ChaseZhang-ai/chipDesign/docs/images/die_shot_ame.png

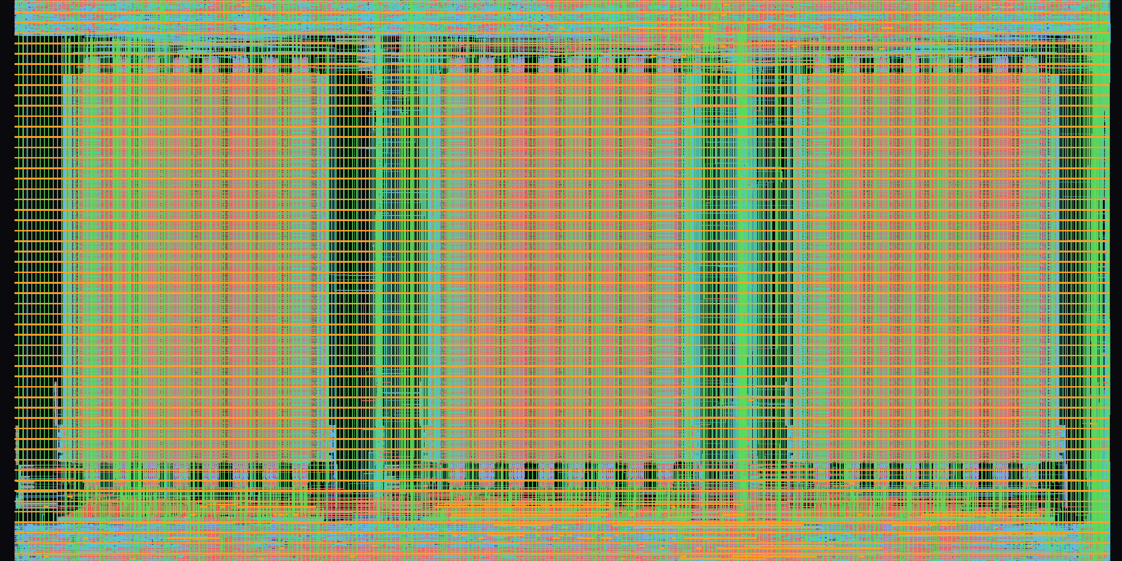
docs/images/die_shot_ame.png
