ChaseZhang-ai/chipDesign/docs/images/die_shot_full.png

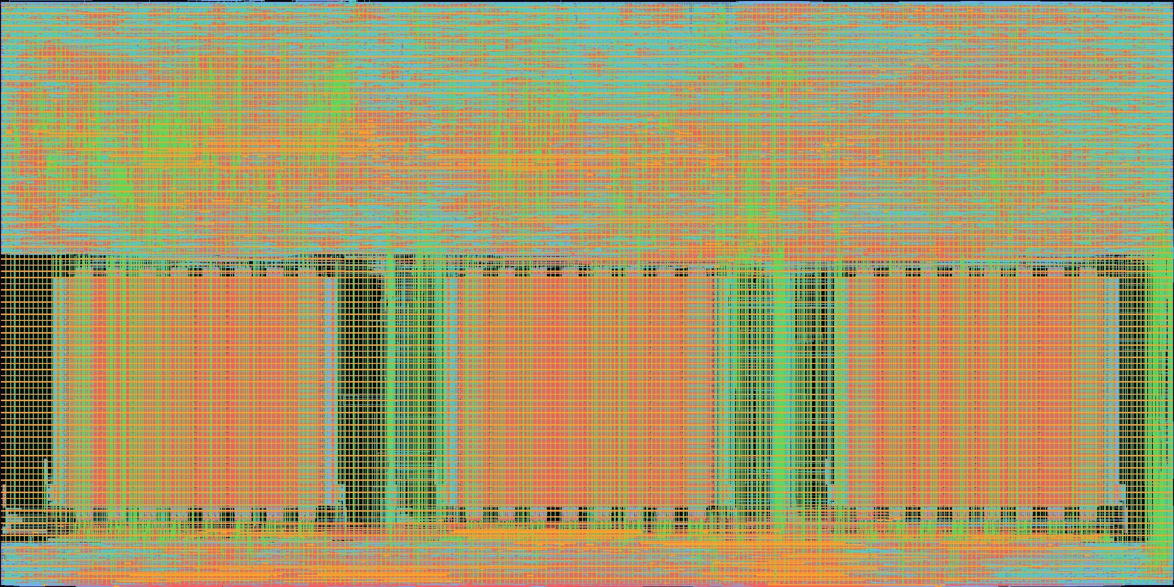
docs/images/die_shot_full.png
