ChaseZhang-ai/chipDesign/reports/P4B_gds_full.png

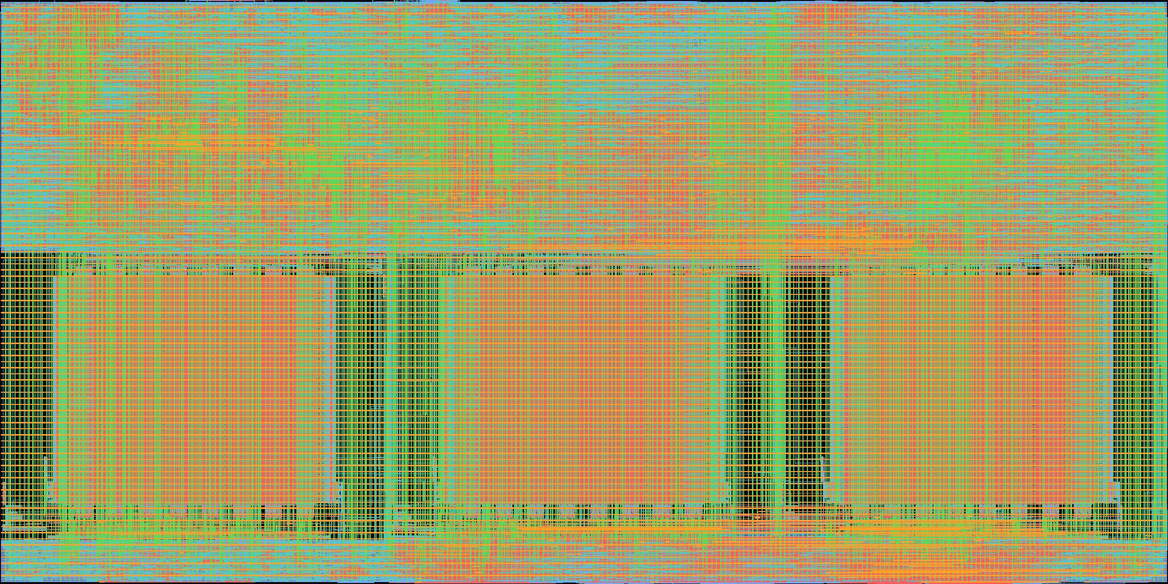
reports/P4B_gds_full.png
