ChaseZhang-ai/chipDesign/(commit log)

2026-10-27 AME-Chip v0.1 — AI-agent-designed RISC-V + matrix-engine decode accelerator
    Tapeout candidate on SkyWater sky130hd, designed end-to-end by orchestrated
    AI-agent sessions on a fully open-source toolchain (Yosys / OpenROAD /
    KLayout / OpenRAM).
    Signoff: 94.78 MHz operating point (10.551 ns, WNS +0.40) / 98.52 MHz fmax /
    die 4.524 mm2 (instances 3.455 mm2) / 241.8 mW / 15.76 mJ per token /
    15.3 tok/s. Function: 3/3 decode tokens bit-exact RTL-vs-golden, gate-level
    netlist byte-identical to RTL (46-byte criterion), checklist FAIL=0.
    Layout of this snapshot:
    rtl/ RTL v0.3 (frozen) — RV32IM core, AME INT8 matrix engine,
    memory subsystem, SoC top, interface contracts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
    [ame_array.sv, ame_buf_rf.sv, ame_coproc_if.sv, ame_core.sv, ame_cpu.sv, ame_ctrl.sv, ame_dma_if.sv]
2026-10-27 docs: visual reporting assets — die shots, architecture/area/throughput/flow diagrams
    - docs/images/die_shot_{full,ame}.png: final-layout render from the p4a4fix
    GDS (KLayout batch, same renderer as the signoff census)
    - architecture.svg, area_breakdown.svg, throughput_context.svg, agent_flow.svg:
    hand-built vector diagrams embedded in README (GitHub-native rendering)
    - README reworked around the visuals: die shot hero, results table, honest
    attainment context against the roofline and the charter caps
2026-10-27 docs: annotated die/AME images and jump-linked README
    - docs/images/die_annotated.png: full die with per-block boxes (OC SRAM /
    WBUF / XBUF macros at their exact GDS coordinates, CPU, memory, AME array)
    - docs/images/ame_annotated.png: AME close-up from the final GDS with labeled
    MAC array, WBUF/XBUF buffers, requant table, control FSM — block locations
    derived from the post-route ODB instance database, not hand-drawn
    - README: click-to-jump table of contents, annotated images embedded in each
    section, self-contained per-section explanations
